telzo2000/cool844/qmk_firmware/keyboards/cool844/readme.md

# cool844

cool844

*A short description of the keyboard/project*

* Keyboard Maintainer: [m.ki](https://github.com/yourusername)
* Hardware Supported: *The PCBs, controllers supported*
* Hardware Availability: *Links to where you can find this hardware*

Make example for this keyboard (after setting up your build environment):

    make cool844:default

Flashing example for this keyboard:

    make cool844:default:flash

See the [build environment setup](https://docs.qmk.fm/#/getting_started_build_tools) and the [make instructions](https://docs.qmk.fm/#/getting_started_make_guide) for more information. Brand new to QMK? Start with our [Complete Newbs Guide](https://docs.qmk.fm/#/newbs).
