telzo2000/cool844/img/img01.png

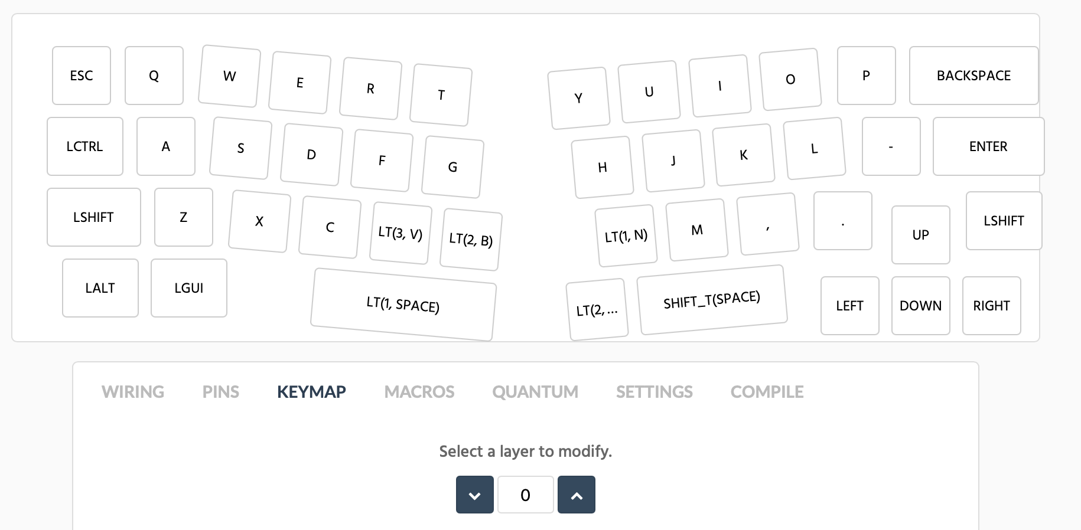
img/img01.png
