telzo2000/cool844/img/img02.png

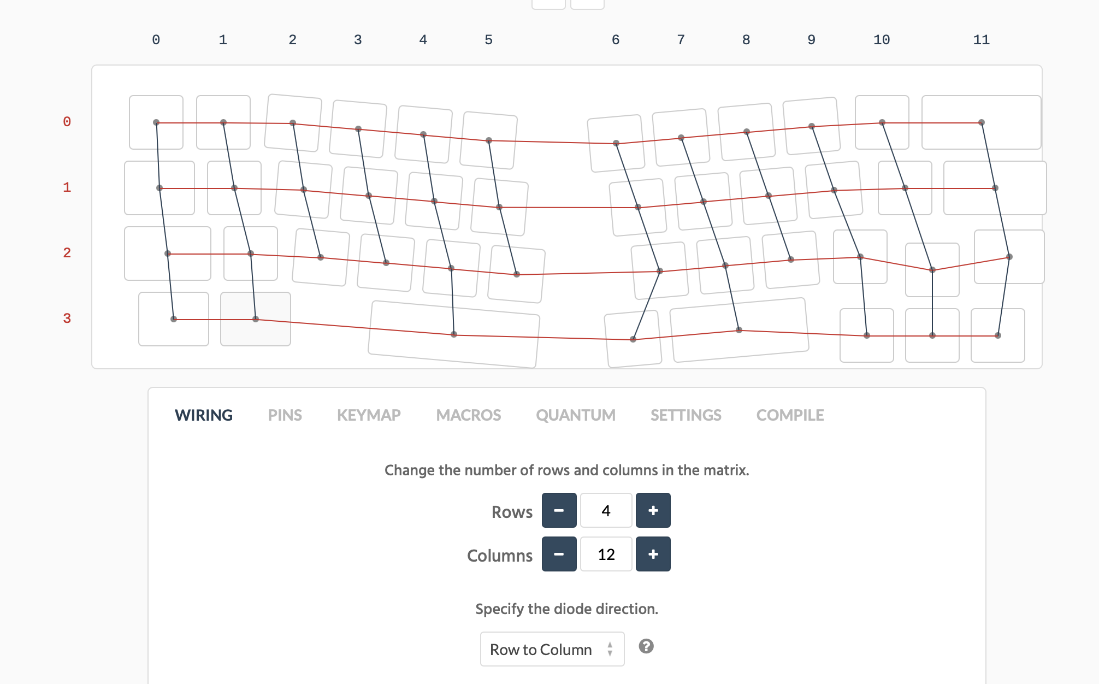
img/img02.png
