telzo2000/cool844/img/img03.png

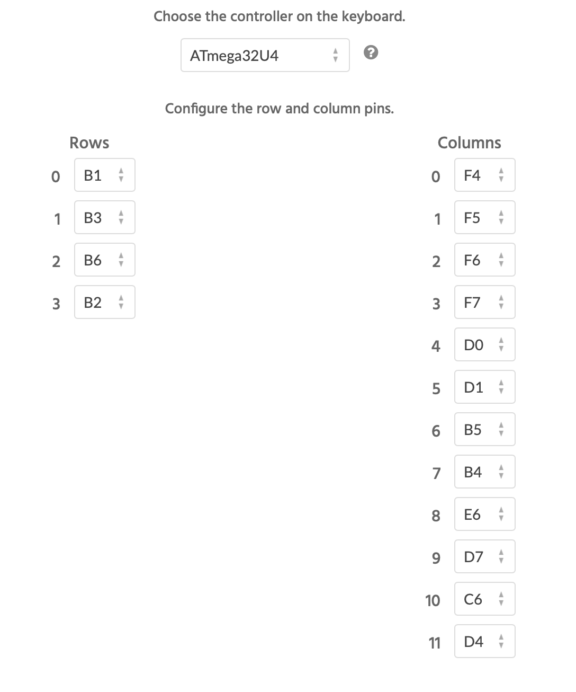
img/img03.png
