telzo2000/cool844/img/img04.png

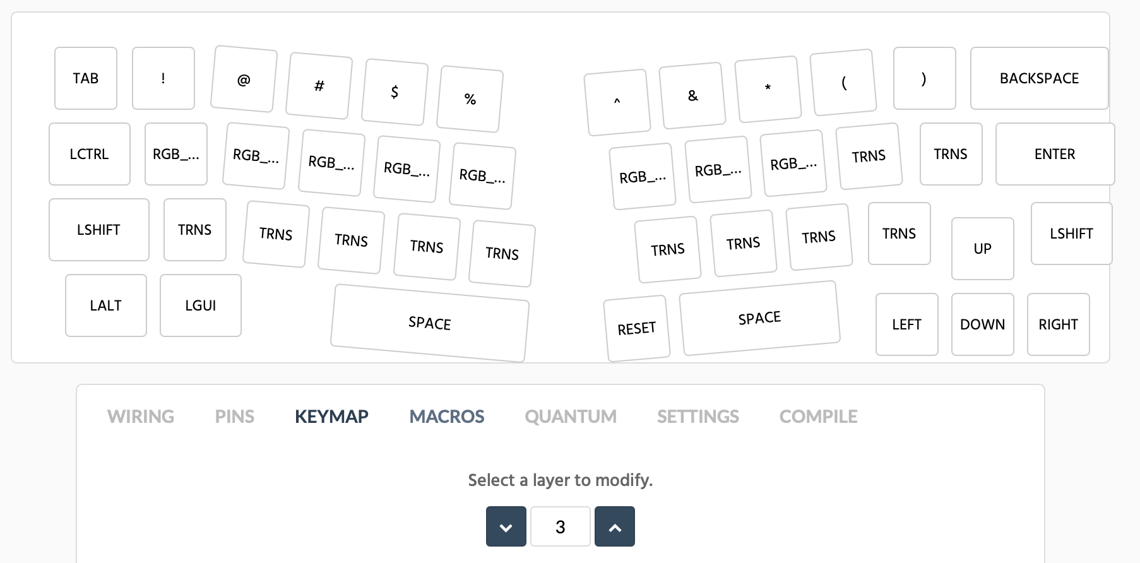
img/img04.png
