telzo2000/cool844/img/img05.png

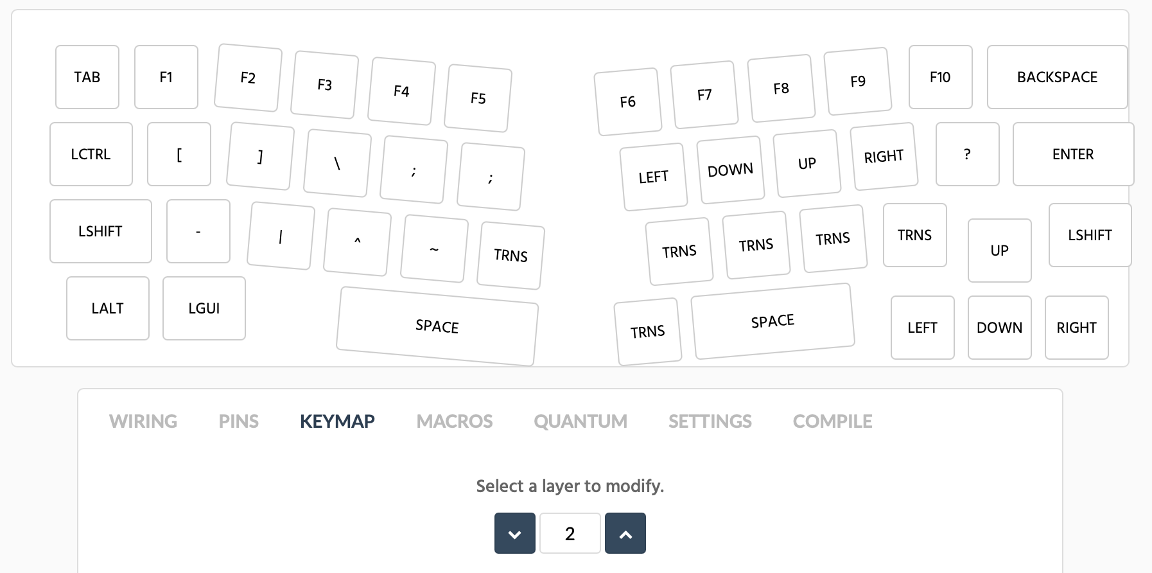
img/img05.png
