telzo2000/cool844/img/img06.png

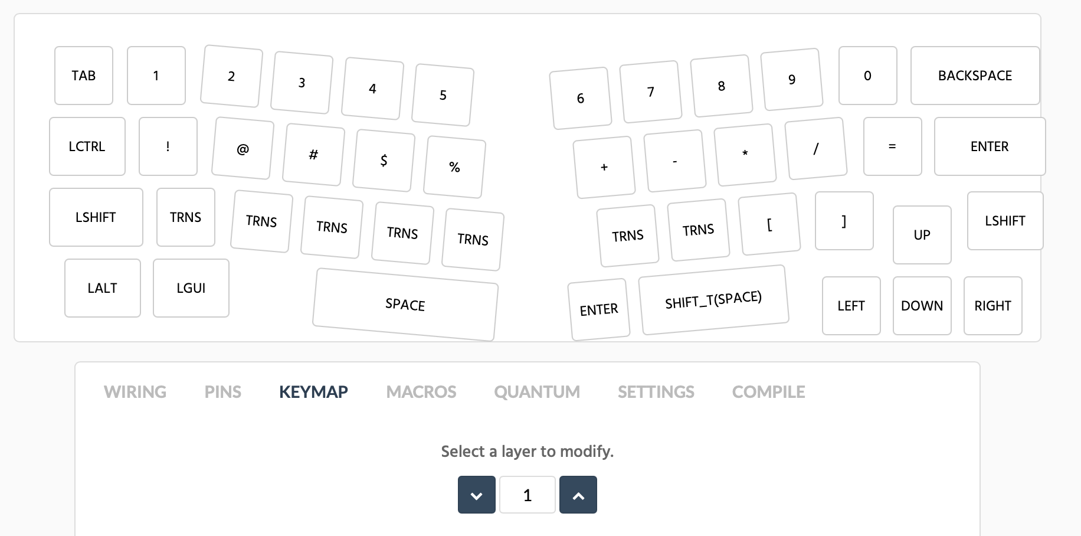
img/img06.png
