telzo2000/cool844/img/img07.png

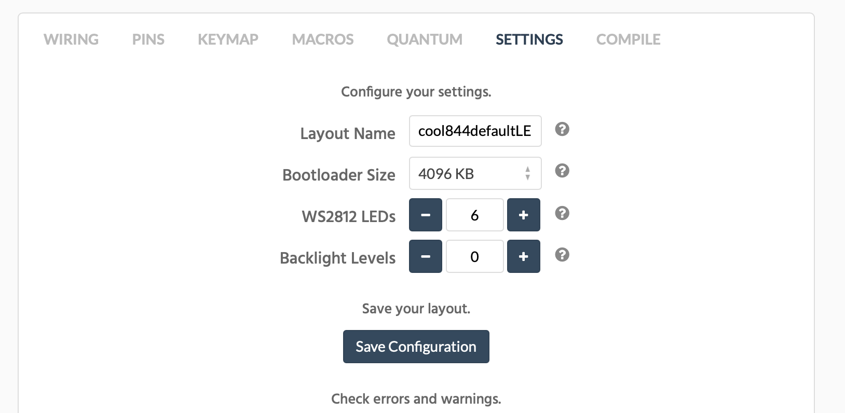
img/img07.png
