telzo2000/cool844/img/IMG_4266.jpg

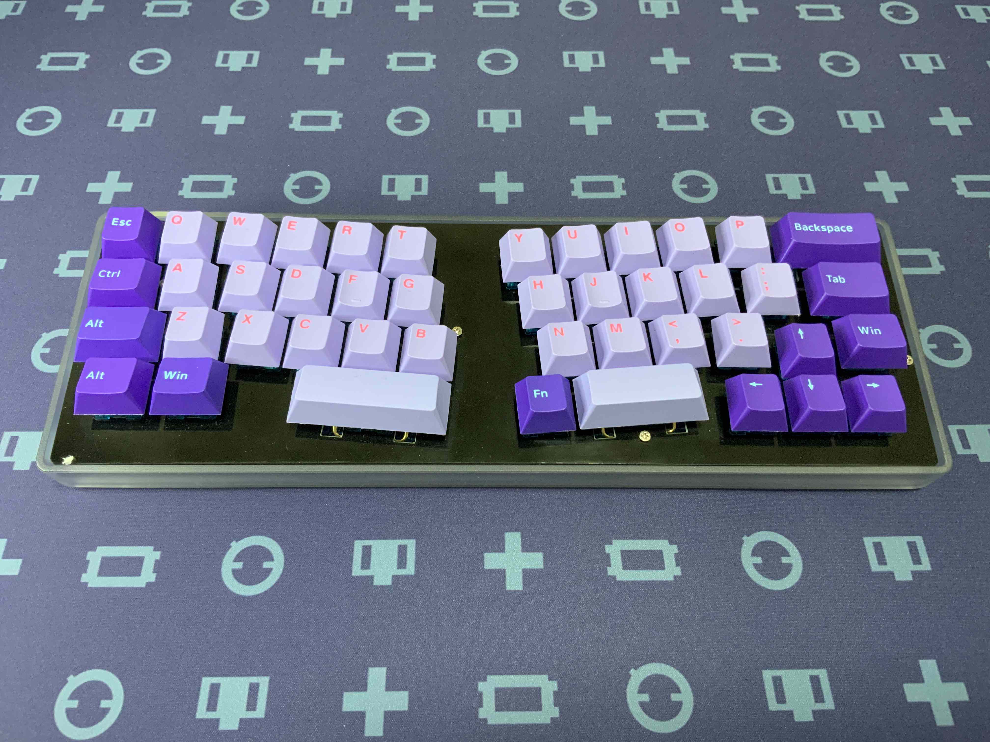
img/IMG_4266.jpg
