telzo2000/cool844/img/IMG_4267.jpg

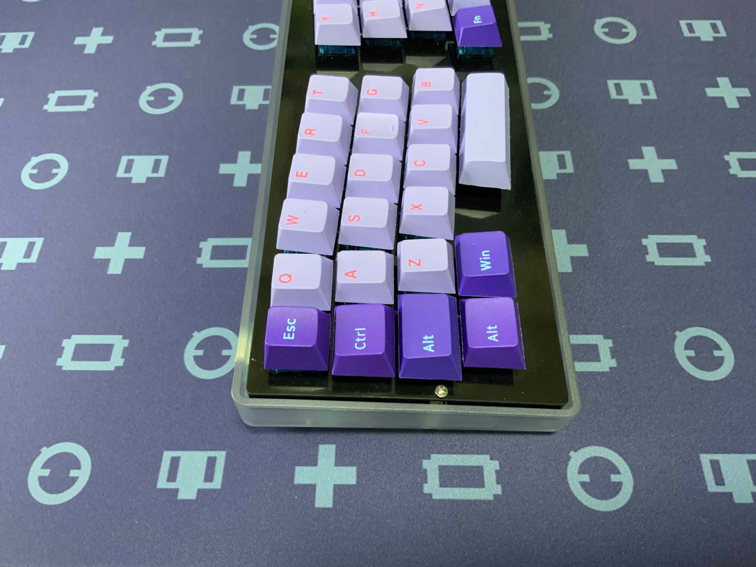
img/IMG_4267.jpg
