telzo2000/cool844/img/IMG_4268.jpg

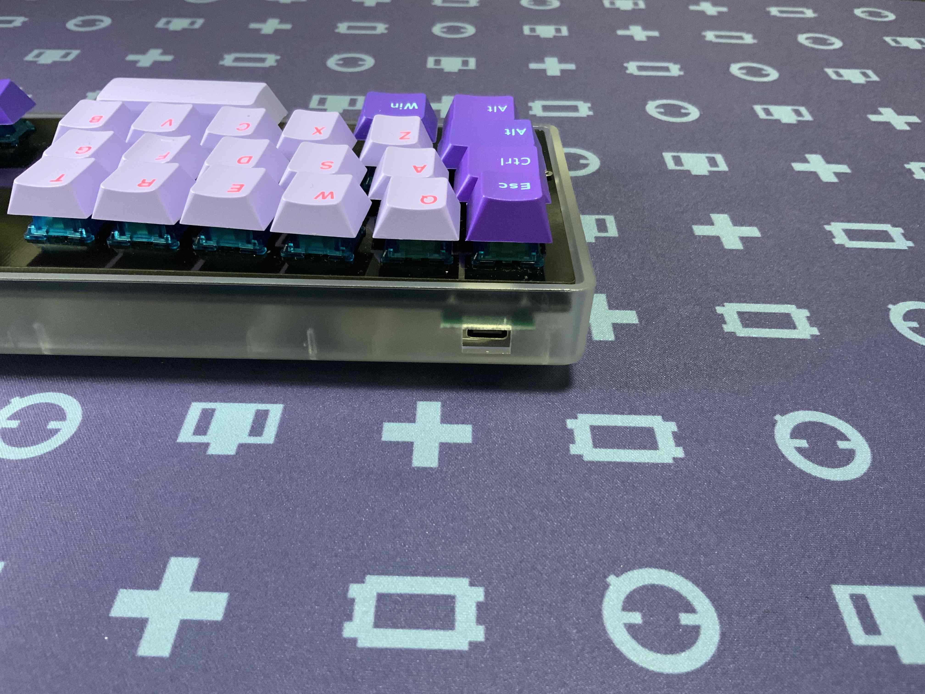
img/IMG_4268.jpg
