telzo2000/cool844/img/IMG_4269.jpg

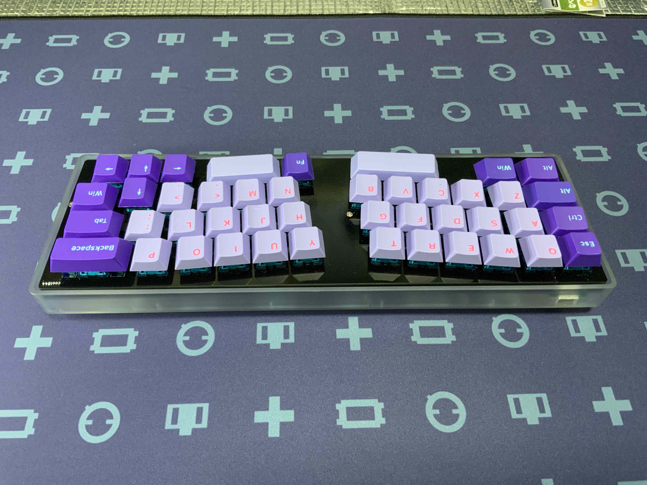
img/IMG_4269.jpg
