telzo2000/cool844/img/IMG_4270.jpg

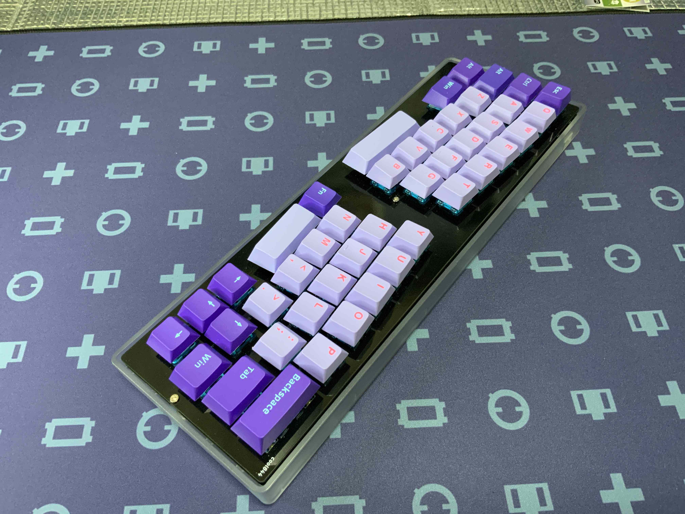
img/IMG_4270.jpg
