telzo2000/cool844/img/IMG_4271.jpg

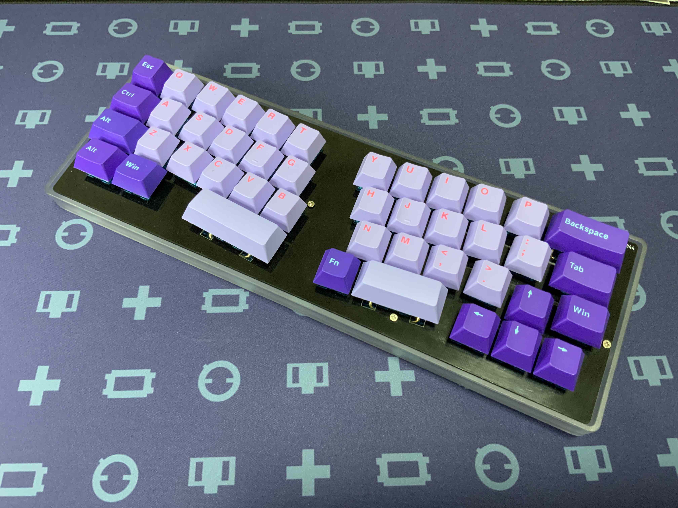
img/IMG_4271.jpg
