telzo2000/cool844/img/remap001.png

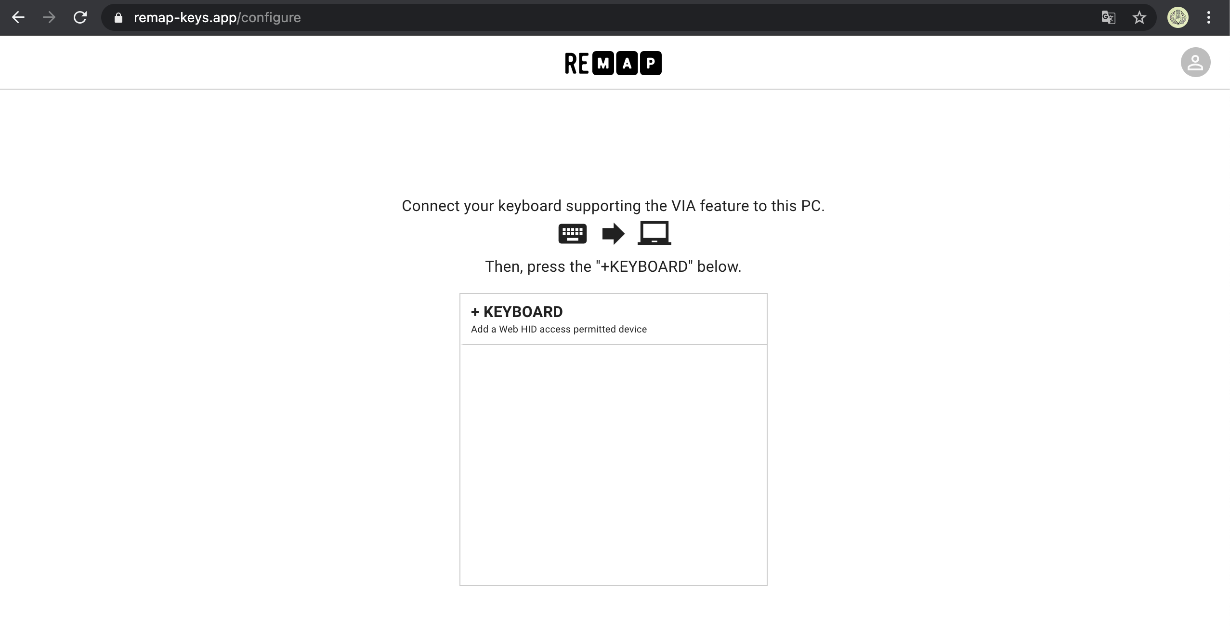
img/remap001.png
