telzo2000/cool844/img/remap002.png

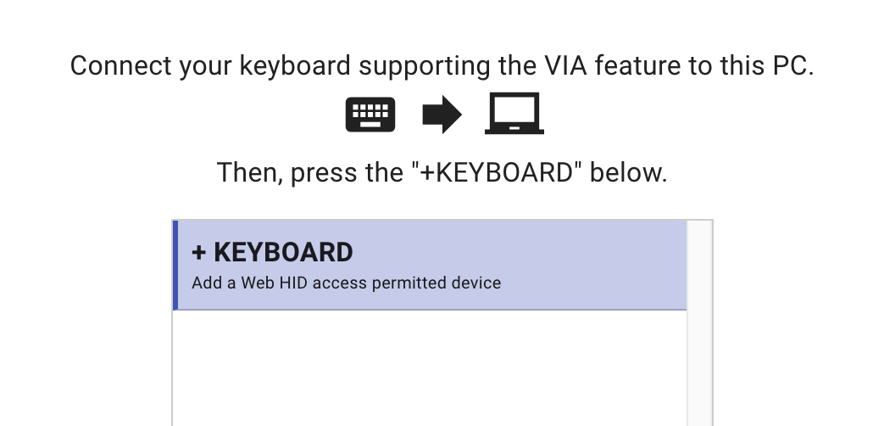
img/remap002.png
