telzo2000/cool844/img/remap003.png

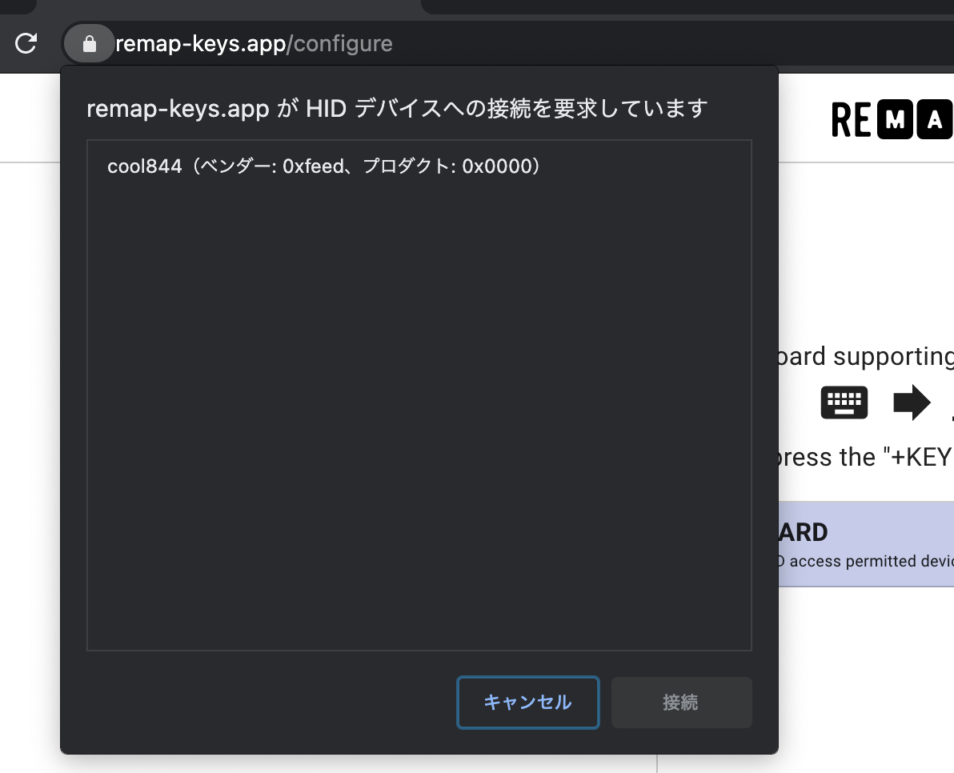
img/remap003.png
