telzo2000/cool844/img/remap004.png

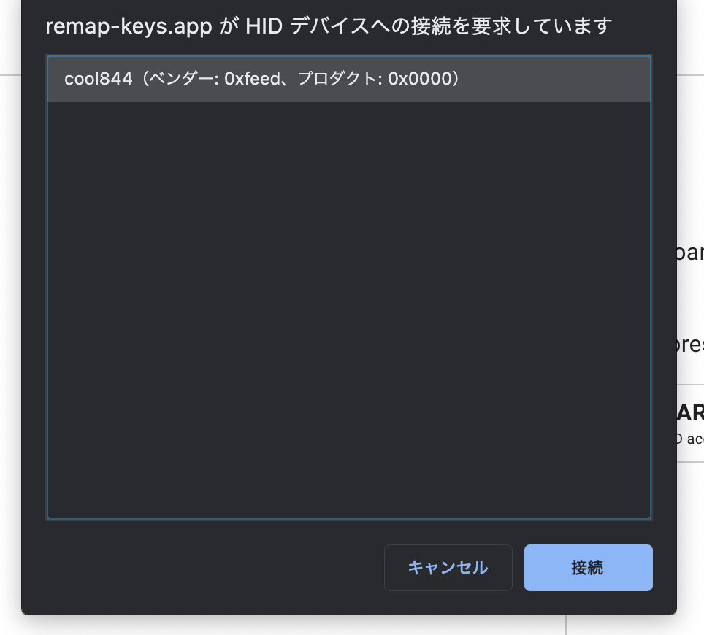
img/remap004.png
