telzo2000/cool844/img/remap005.png

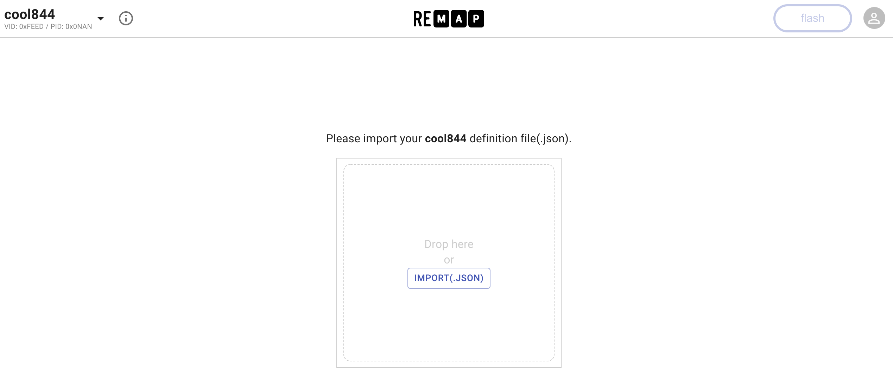
img/remap005.png
