telzo2000/cool844/img/remap006.png

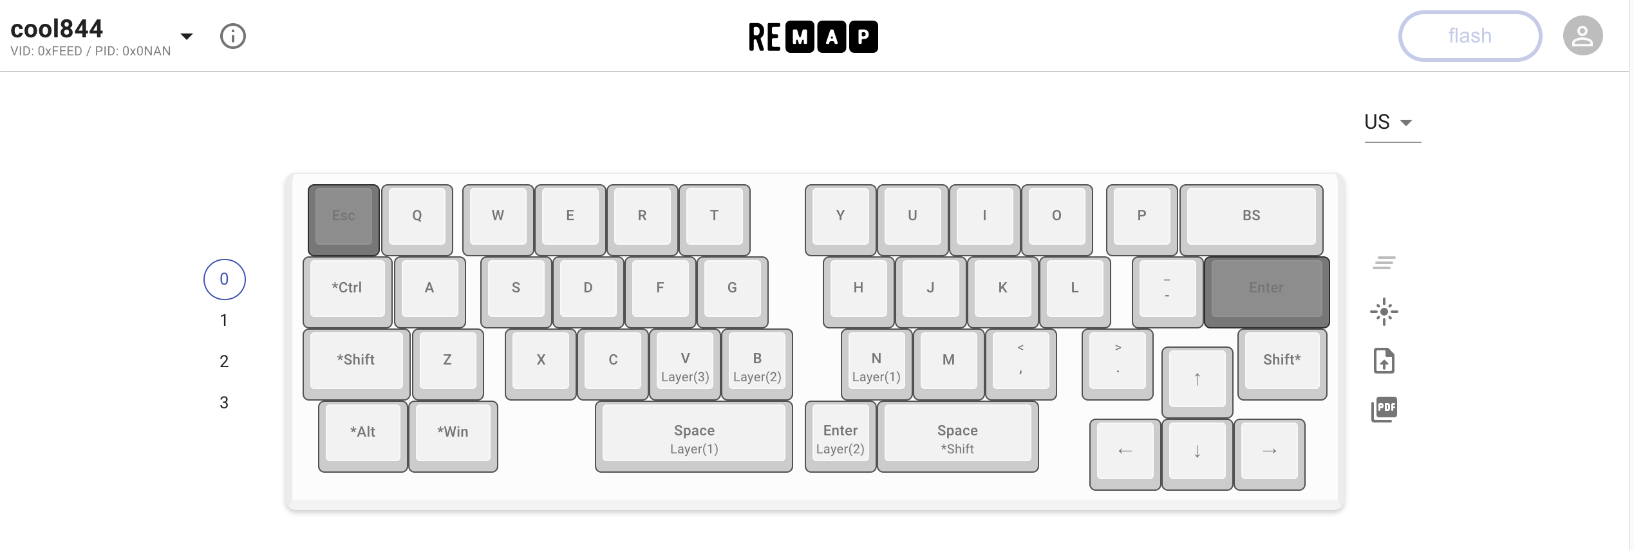
img/remap006.png
