telzo2000/cool844/buildguideforcool844.md

# cool844ビルドガイド

## ◯同封されているもの

スイッチプレート　１枚<br>
PCB １枚<br>

## ◯別途に購入するもの（１）
M2スペーサー10mm 5個<br>
M2ネジ15mm 5本<br>
ウレタンケーブル25cm<br>
ダイオード　44本<br>
MXソケット　44個<br>
タクトスイッチ　1個<br>
キースイッチ　44個<br>
キーキャップ<br>
スタビライザー２U ３個<br>
pro micro １個<br>
スプリングピンヘッダ（マックエイトコンスルー）２個<br>
フルカラーシリアルLEDテープ　２枚<br>
※これらのものについては、[遊舎工房](https://shop.yushakobo.jp)、[TALP KEYBOARDs](https://talpkeyboard.stores.jp)、[KOCHI KEYBOARD](https://kochikeyboard.stores.jp)等国内で自作キーボードに関する部品等を取り扱っているお店で購入することができます。M2スペーサー10mmは、外径の小さいものが最適です[KOCHI KEYBOARD](https://kochikeyboard.stores.jp)で[取り扱っているもの](https://kochikeyboard.stores.jp/items/5f8aabbdd24eee436e27e967)を推奨します。
<br>

## ◯別途に購入するもの（２）
[マイクロUSB端子（オス）](https://akizukidenshi.com/catalog/g/gC-07666/)<br>
[USB タイプC基板](https://akizukidenshi.com/catalog/g/gK-15426/)<br>
※これらのものについては、[秋月電子通商](https://akizukidenshi.com/catalog/)で購入することができます。

## ◯別途に購入するもの（3）
ケース
※GH60系60％キーボードケースを使うことを前提になっています。国内では[遊舎工房](https://shop.yushakobo.jp)等で、海外では[Ali Expresse](https://best.aliexpress.com/)等で同じようなケースを材質ごとに、見つけることができます。cool844がケース全てに使えるか確認することは、個人の裁量を超えます。購入者の自己責任でお願いします。
<br>

## ◯ファームウェア
このキーボードはQMKというキーボード用のソフトウェアで動作するようにプログラミングしています。<br>
[Yoichiro Tanaka@yoichiro](https://twitter.com/yoichiro)さん等が開発した[REMAP](https://remap-keys.app/)が使用できます。
<br>
pro microとPCをUSBケーブルで繋ぎ、google chromeで[REMAP](https://remap-keys.app/)サイトへアクセスしてください。<br>

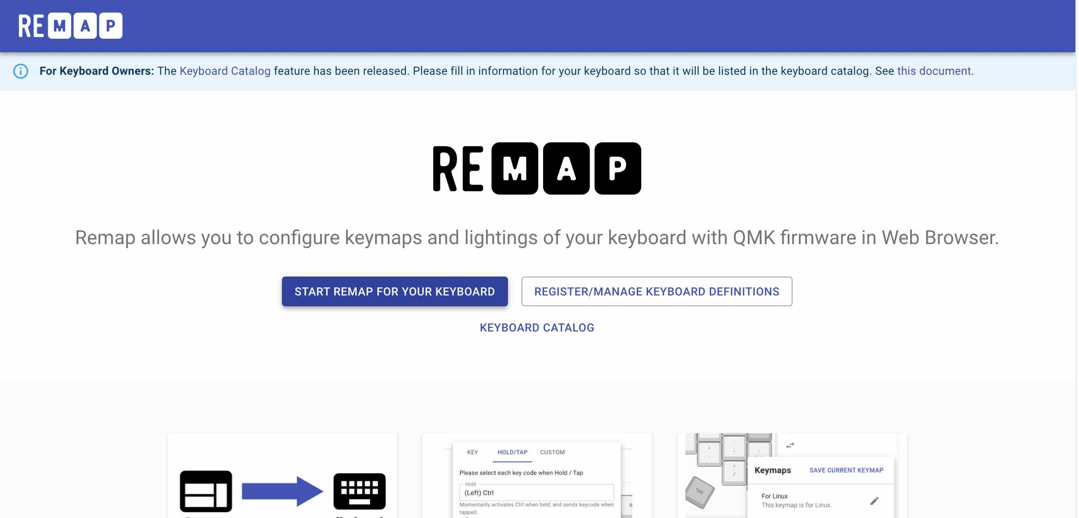
[picture p22: img/img00079.jpg]


画面中央の「KEYBOARD CATALOG」をクリックしてください。<br>
画面が変わりましたら、左上の「Keyboard Name」に「cool」と
入力して、下部の「SEARCH」をクリックしてください。
<br>
coolシリーズのキーボードが表示されます。
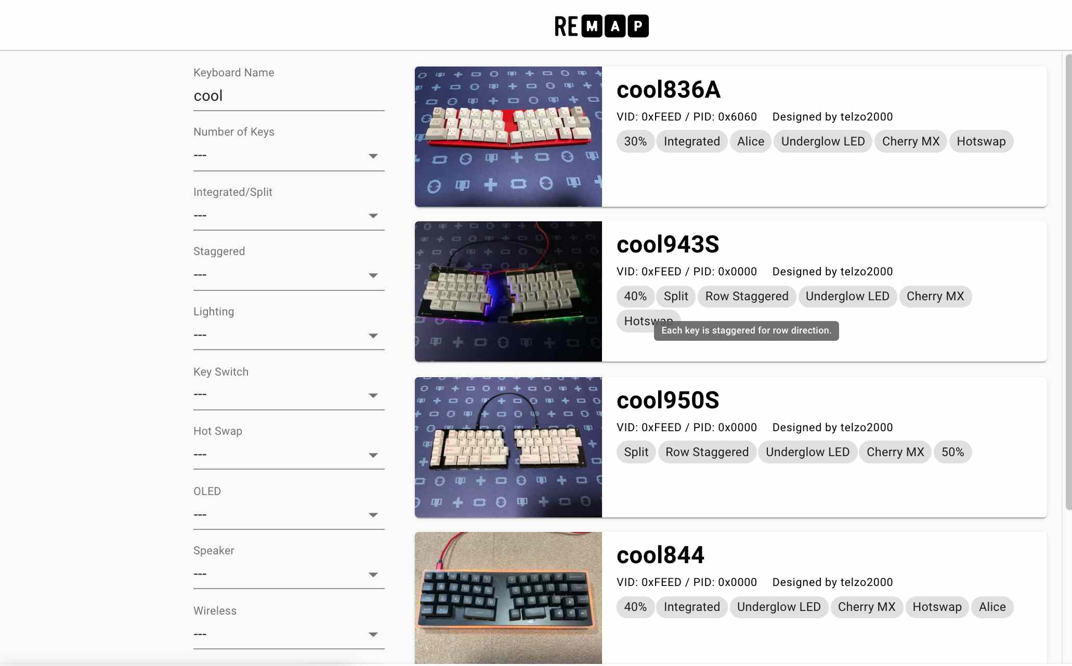
[picture p23: img/img00080.jpg]

この中から、該当するキーボードを選び、クリックしてください。
<br>
例えば、cool844であれば、次の画面に変わります。
そこでタブの「FIRMWARE」をクリックすると、
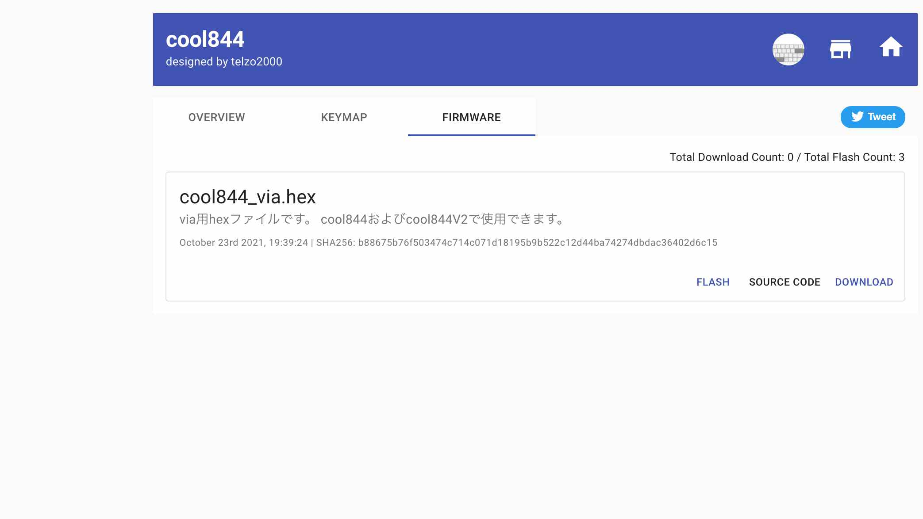
[picture p24: img/img00081.jpg]

このように、via用hexファイルが表示されます。
「FLASH」をクリックすると、
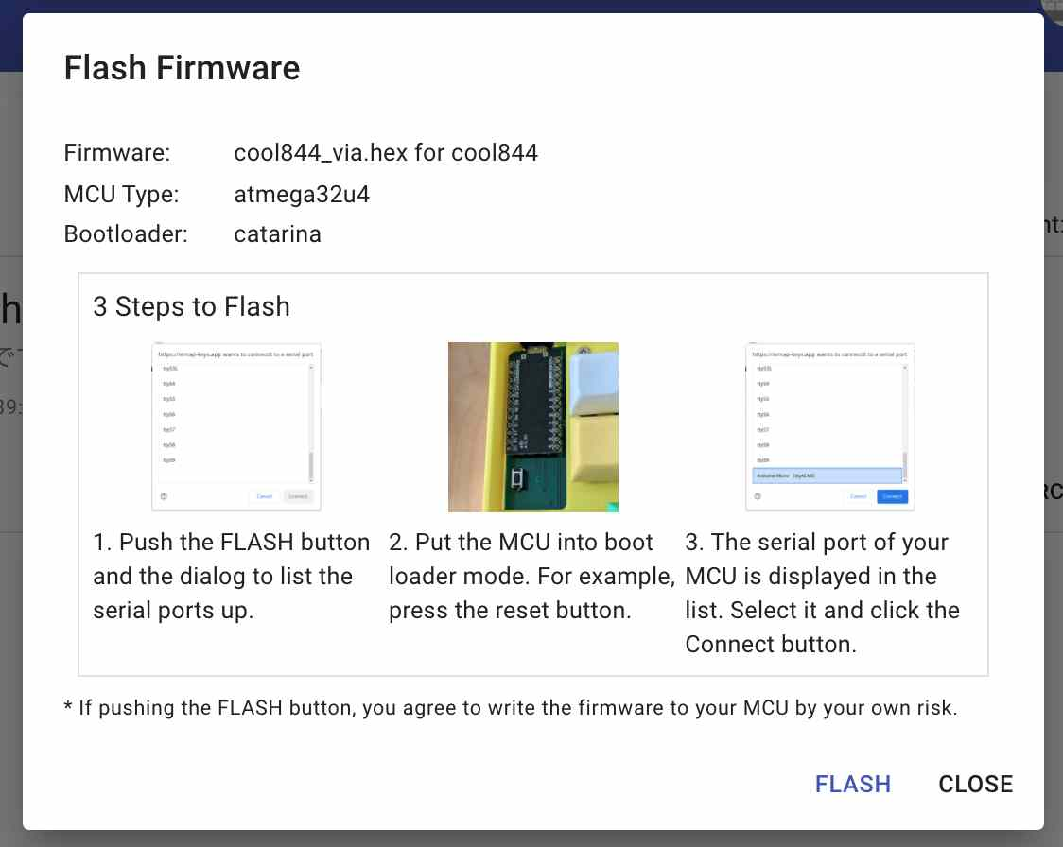
[picture p25: img/img00082.jpg]

Flash Firmwareが起動して、pro microへの書き込みができます。
<br>
以上で、pro microへのファームウェアの書き込みは完了です。
<br>
REMAPのおかげで、自作キーボードのファームウェアの書き込み、キーレイアウトの変更が大変、簡単になりました。
<br>
<br>
## ◯組み立て

### １　表裏面の確認
スイッチプレートとPCBは、表面の右上にcool 844と印字されています。特にPCBは、diode 、socketと印字されている面が裏面です。

### ２　ダイオードのハンダ付け
PCB 裏面にダイオードのハンダ付けをします。ダイオードの足を曲げて取り付けて、ハンダ付けをします。ダイオードの足は、下面から「diode」と印刷された部分の穴に差し込みます。上面に伸びたダイオードの足は切り離してください。ダイオードには極性があります。ダイオードの黒い帯がある側が「diode」の文字の後ろになるようにハンダ付けしてください。ハンダ付けに自信がない場合、フラックスを利用すると、上手にハンダ付けができます。その後、フラックスクリーナーで綺麗に拭き取ることをお勧めします。１箇所印字されていないミスが確認できています。それ以外のダイオードのハンダ付けを参考にして、ハンダ付けをしてください。

### ３　MXソケットのハンダ付け
PCB 裏面にMXソケットのハンダ付けをします。PCB 裏面の端子箇所に多めにフラックスを塗布して、予備ハンダをしてください。MXソケットをsocket と印字を隠すように置いて、ハンダゴテを当てて、予備ハンダを溶かしながら、ハンダ付けをしてください。

### ４　タクトスイッチの取り付け
PCB裏面にresetと書かれた箇所があります。そこにタクトスイッチをハンダ付けしてください。

### ５　pro microの取り付け<br>
　本製品ではコンスルー（スプリングピンヘッダ）を使用してのpro microの装着を推奨しています。コンスルー（スプリングピンヘッダ）の向きに気をつけて使用してください。画像を参考にして、pro microの向きに注意してください。<br>
pro microを装着したさ、pro microの基板がたくさん載っている側が下向きになります。cool836AのVer.C+（イエローバージョン）と同じ付け方になります。

### ６ ドーターボードの作成と取り付け
ドーターボードの作成は[こちら](https://github.com/telzo2000/Hello_keyboard/blob/main/dbforcool844/buildlog.md)になります。
取り付け方は、次の画像（試作品）を参考にしてください。<br>
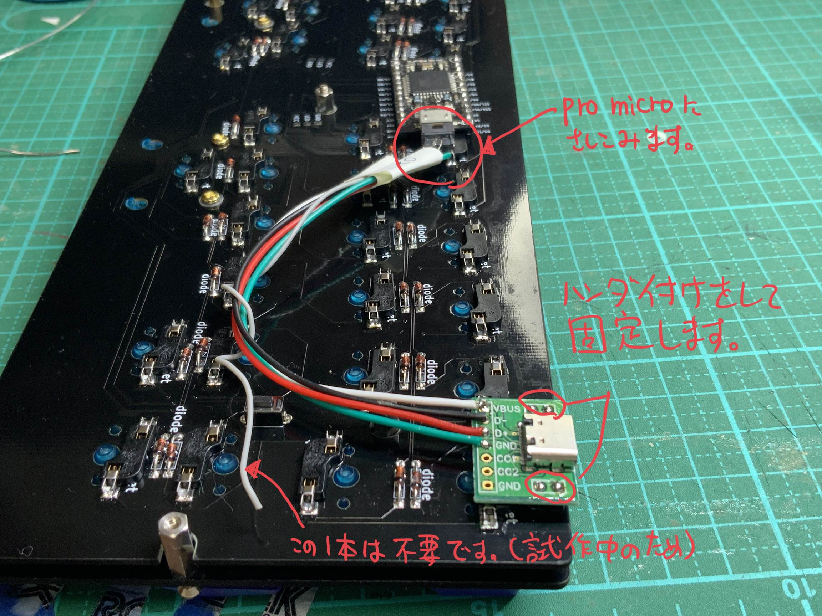
[picture p26: img/IMG_4257.jpg]

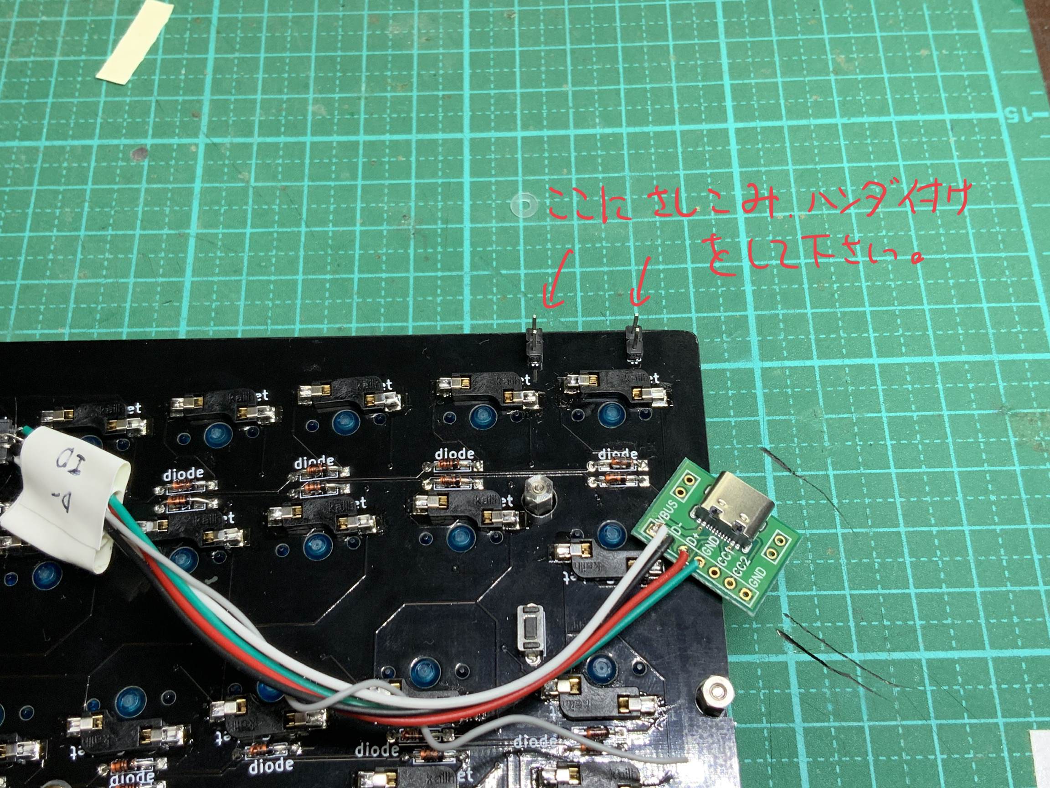
[picture p27: img/IMG_4255.jpg]

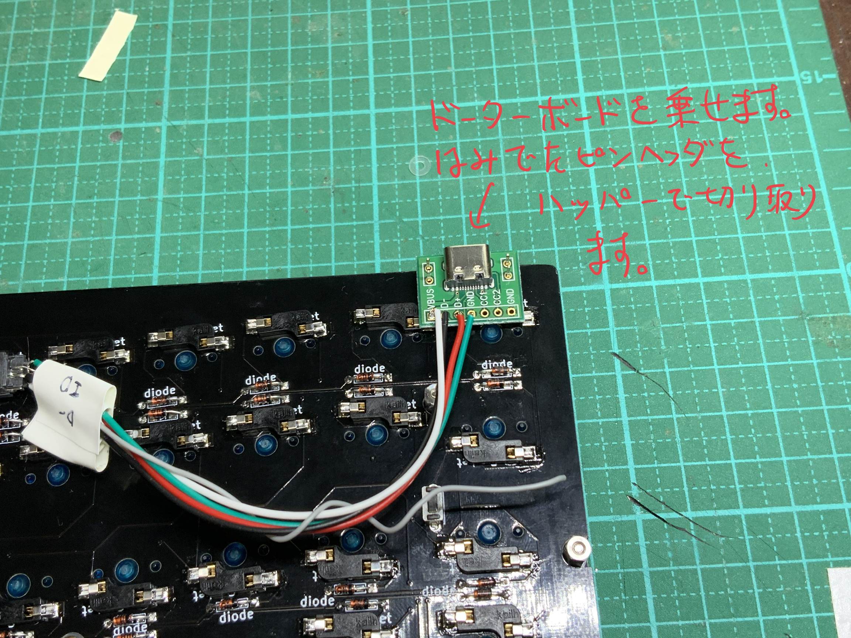
[picture p28: img/IMG_4256.jpg]


（令和3年10月27日追記）取り付けの際、PCBとUSBタイプC基板との間隔を３〜４mmにしてください。
この間隔は、ケースのUSB挿し込み口と位置を合わせてからハンダ付けをしてください。
### ７　スタビライザーの取り付け
PCB表面３箇所に、２Uのスタビライザーを取り付けます。スタビライザーに事前に、ルブしておくことをお勧めします。

### ８　キースイッチの取り付け<br>
最初にキースイッチ５個をトッププレートの５箇所（四隅と一番手前）に差し込みます。一度に全部のキースイッチを取り付けて、その後にPCBにハンダ付けしたMXソケットに差し込むとうまくいかないことが予想されます。５箇所で一度PCBにハンダ付けしたMXソケットに差し込み、残りのキースイッチをトッププレート、PCBの順に差し込んでください。それぞれのキースイッチの足がきちんとMXソケットの基板の穴に差し込まれていることを確認してください。差し込むときに、足が曲がってしまうことがあります。その場合は、ボタンを押しても入力されません。一度キースイッチを外して、足の修正または新しいキースイッチに交換等対処してください。

### 9 フルカラーシリアルLEDテープの取り付け
PCB裏面に、テープの裏面の保護紙を剥がして貼り付けます。その後、それぞれの端子にハンダを山盛りにして導通させてください。
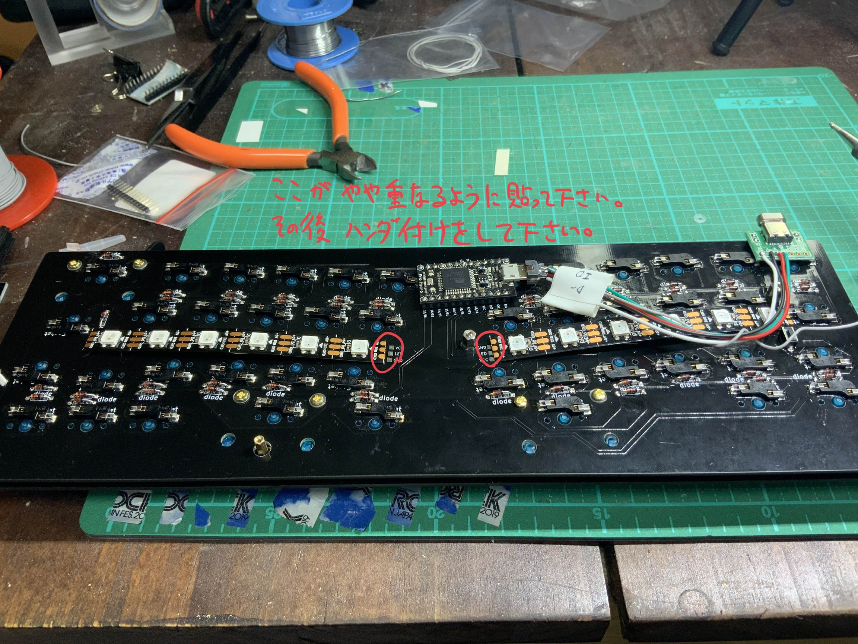
[picture p29: img/IMG_4258.jpg]

この後、ファームウェアを入れて、入力できるかテストをしてください。

### 10　ネジ、スペーサーの取り付け
スイッチプレート表面からネジを通して、スペーサーも通しておきます。５箇所全て、その状態にします。<br>
ケースにスイッチプレート等を差し込んで、ネジを締めます。締めたり、緩めたりを繰り返すうちに、ネジ山が上手に溝に入り込んで、締めることができます。プラスチック製ケースではスイッチプレートがケース壁面上部より１mm程度下がった位置で、ネジは締まりました。締めすぎて、ネジ山を壊さないよう、注意してください。
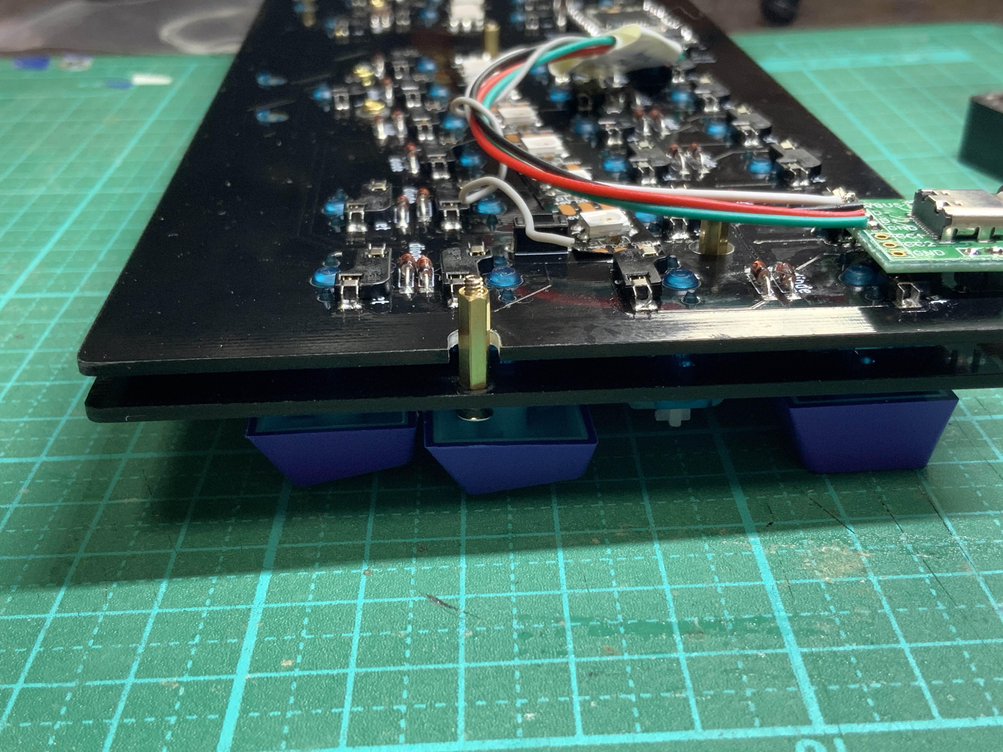
[picture p30: img/IMG_4259.jpg]


### 11　右奥箇所のねじ止め（ver.1.1）
ケース右奥箇所の固定のため、PCBの一部に作成されたプレート（リーフ）を切り離してください。<br>
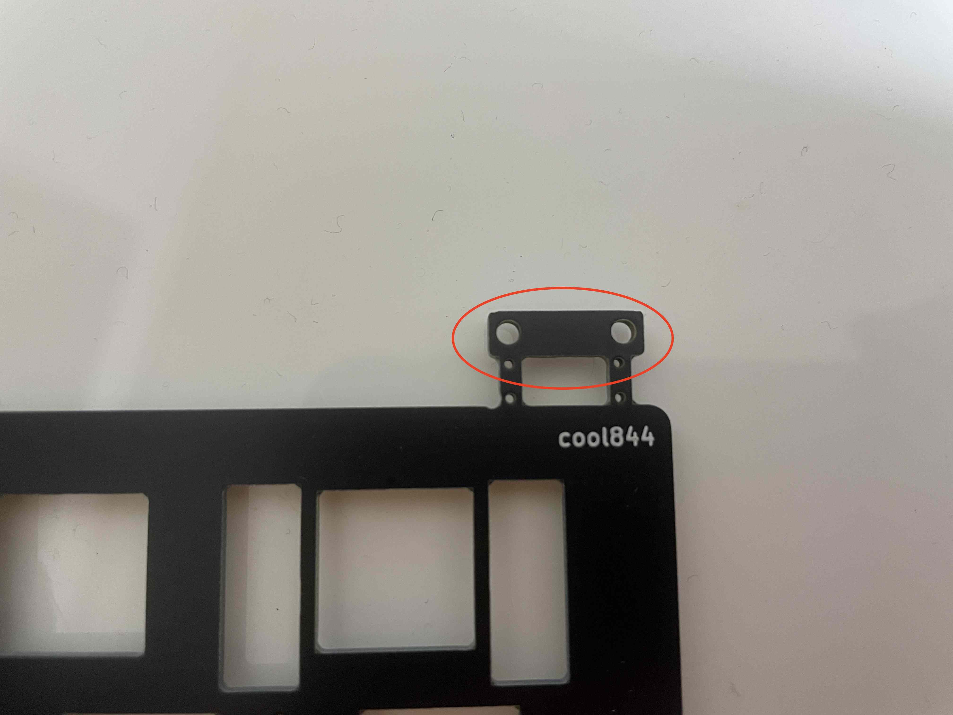
[picture p31: img/IMG_0935.jpg]

このパーツをM2ネジ４mm２本、ワッシャー１枚、M2スペーサー８mmを組み合わせて、次のようにしてください。<br>
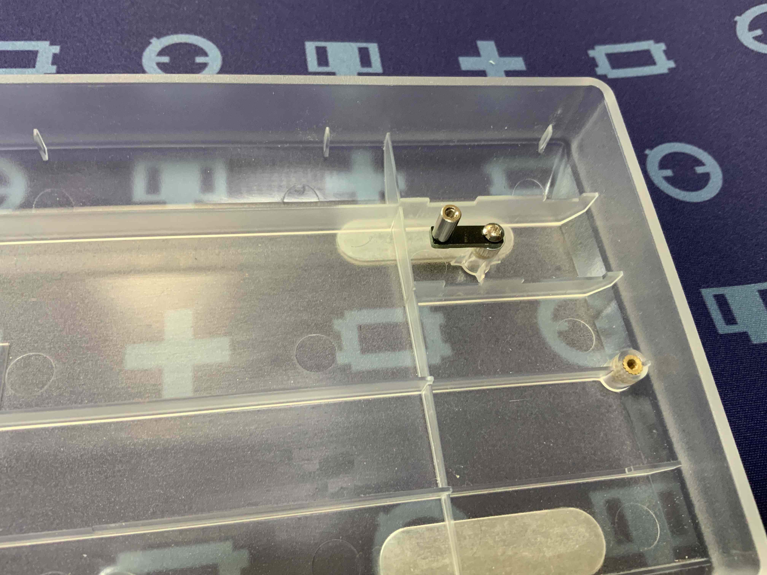
[picture p32: img/IMG_4441.jpg]

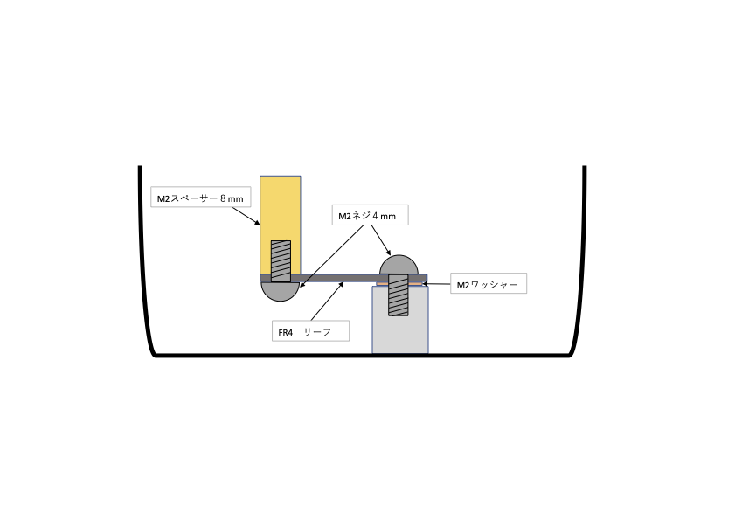
[picture p33: img/img08.png]


全体像としては、次の通りです。
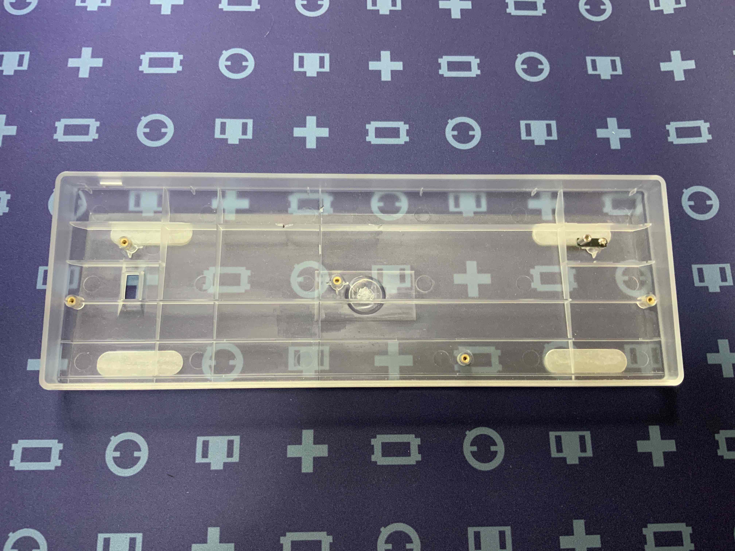
[picture p34: img/IMG_4440.jpg]

この箇所（次の画像の赤丸部分）をスイッチプレートで固定するときは、M2ネジ４mmを使用してください。<br>
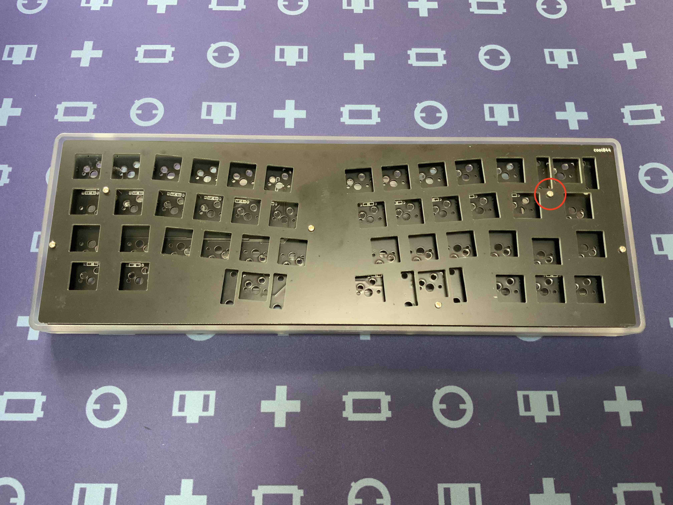
[picture p35: img/IMG_4439.jpg]


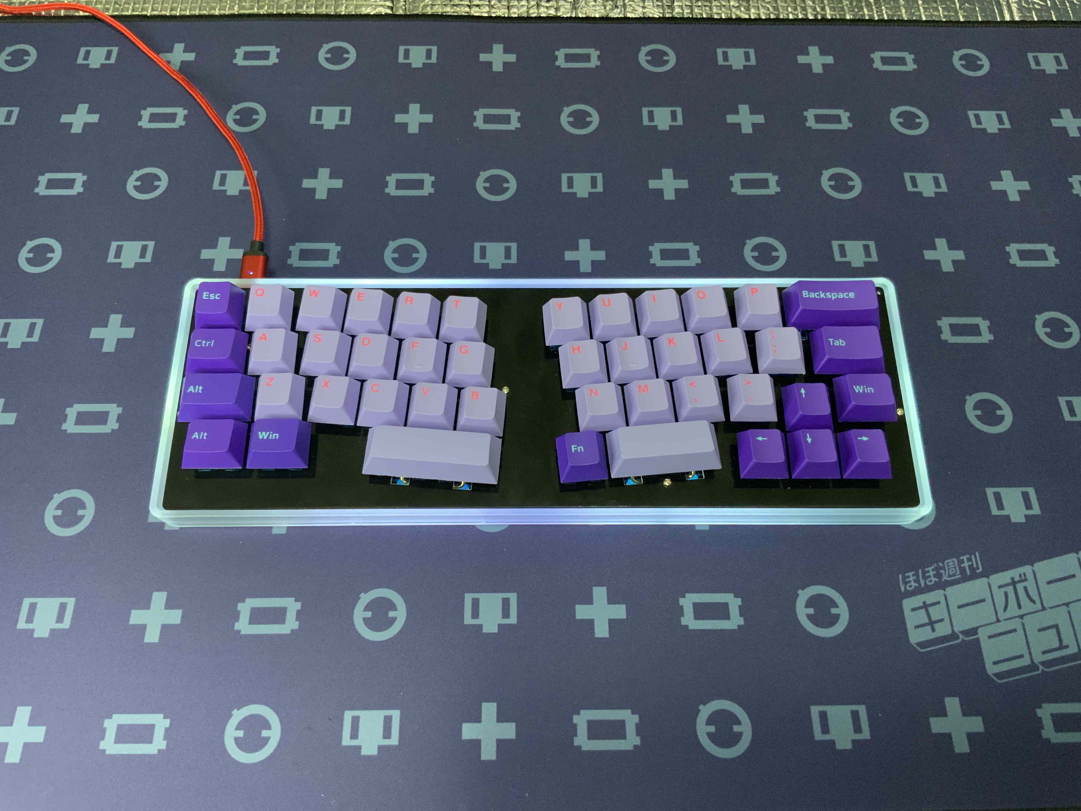
[picture p36: img/IMG_4299.jpg]
