telzo2000/cool844/qmk_firmware/keyboards/cool844/config.h

/*
Copyright 2021 m.ki

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
You should have received a copy of the GNU General Public License
along with this program.  If not, see <http://www.gnu.org/licenses/>.
*/

#pragma once

#include "config_common.h"

/* USB Device descriptor parameter */
#define VENDOR_ID    0xFEED
#define PRODUCT_ID   0x0000
#define DEVICE_VER   0x0001
#define MANUFACTURER m.ki
#define PRODUCT      cool844

/* key matrix size */
#define MATRIX_ROWS 4
#define MATRIX_COLS 12

/*
 * Keyboard Matrix Assignments
 *
 * Change this to how you wired your keyboard
 * COLS: AVR pins used for columns, left to right
 * ROWS: AVR pins used for rows, top to bottom
 * DIODE_DIRECTION: COL2ROW = COL = Anode (+), ROW = Cathode (-, marked on diode)
 *                  ROW2COL = ROW = Anode (+), COL = Cathode (-, marked on diode)
 *
 */
#define MATRIX_ROW_PINS { B1,B3,B6,B2 }
#define MATRIX_COL_PINS { F4,F5,F6,F7,D0,D1,B5,B4,E6,D7,C6,D4 }
#define UNUSED_PINS

/* COL2ROW, ROW2COL */
#define DIODE_DIRECTION ROW2COL

/*
 * Split Keyboard specific options, make sure you have 'SPLIT_KEYBOARD = yes' in your rules.mk, and define SOFT_SERIAL_PIN.
 */
#define SOFT_SERIAL_PIN D0  // or D1, D2, D3, E6

#define RGB_DI_PIN D3
#ifdef RGB_DI_PIN
#    define RGBLED_NUM 16
#    define RGBLIGHT_HUE_STEP 16
#    define RGBLIGHT_SAT_STEP 16
#    define RGBLIGHT_VAL_STEP 16
#    define RGBLIGHT_LIMIT_VAL 255 /* The maximum brightness level */
#    define RGBLIGHT_SLEEP  /* If defined, the RGB lighting will be switched off when the host goes to sleep */
/*== all animations enable ==*/
#    define RGBLIGHT_ANIMATIONS
/*== or choose animations ==*/
#    define RGBLIGHT_EFFECT_BREATHING
#    define RGBLIGHT_EFFECT_RAINBOW_MOOD
#    define RGBLIGHT_EFFECT_RAINBOW_SWIRL
#    define RGBLIGHT_EFFECT_SNAKE
#    define RGBLIGHT_EFFECT_KNIGHT
#    define RGBLIGHT_EFFECT_CHRISTMAS
#    define RGBLIGHT_EFFECT_STATIC_GRADIENT
#    define RGBLIGHT_EFFECT_RGB_TEST
#    define RGBLIGHT_EFFECT_ALTERNATING
/*== customize breathing effect ==*/
/*==== (DEFAULT) use fixed table instead of exp() and sin() ====*/
#    define RGBLIGHT_BREATHE_TABLE_SIZE 256      // 256(default) or 128 or 64
/*==== use exp() and sin() ====*/
#    define RGBLIGHT_EFFECT_BREATHE_CENTER 1.85  // 1 to 2.7
#    define RGBLIGHT_EFFECT_BREATHE_MAX    255   // 0 to 255
#endif

/* Debounce reduces chatter (unintended double-presses) - set 0 if debouncing is not needed */
#define DEBOUNCE 5

/* define if matrix has ghost (lacks anti-ghosting diodes) */
//#define MATRIX_HAS_GHOST

/* Mechanical locking support. Use KC_LCAP, KC_LNUM or KC_LSCR instead in keymap */
#define LOCKING_SUPPORT_ENABLE
/* Locking resynchronize hack */
#define LOCKING_RESYNC_ENABLE

/* If defined, GRAVE_ESC will always act as ESC when CTRL is held.
 * This is useful for the Windows task manager shortcut (ctrl+shift+esc).
 */
//#define GRAVE_ESC_CTRL_OVERRIDE

/*
 * Force NKRO
 *
 * Force NKRO (nKey Rollover) to be enabled by default, regardless of the saved
 * state in the bootmagic EEPROM settings. (Note that NKRO must be enabled in the
 * makefile for this to work.)
 *
 * If forced on, NKRO can be disabled via magic key (default = LShift+RShift+N)
 * until the next keyboard reset.
 *
 * NKRO may prevent your keystrokes from being detected in the BIOS, but it is
 * fully operational during normal computer usage.
 *
 * For a less heavy-handed approach, enable NKRO via magic key (LShift+RShift+N)
 * or via bootmagic (hold SPACE+N while plugging in the keyboard). Once set by
 * bootmagic, NKRO mode will always be enabled until it is toggled again during a
 * power-up.
 *
 */
//#define FORCE_NKRO

/*
 * Feature disable options
 *  These options are also useful to firmware size reduction.
 */

/* disable debug print */
//#define NO_DEBUG

/* disable print */
//#define NO_PRINT

/* disable action features */
//#define NO_ACTION_LAYER
//#define NO_ACTION_TAPPING
//#define NO_ACTION_ONESHOT

/* disable these deprecated features by default */
#define NO_ACTION_MACRO
#define NO_ACTION_FUNCTION

/* Bootmagic Lite key configuration */
//#define BOOTMAGIC_LITE_ROW 0
//#define BOOTMAGIC_LITE_COLUMN 0
