telzo2000/cool844/via@otahinosame/cool844/config.h

#ifndef CONFIG_H
#define CONFIG_H

#include "config_common.h"

/* USB Device descriptor parameter */
// TODO : fix VID and PID
#define VENDOR_ID       0xFEED
#define PRODUCT_ID      0x6060
#define DEVICE_VER      0x0001
#define MANUFACTURER    m.ki
#define PRODUCT         cool844
#define DESCRIPTION     Keyboard

/* key matrix size */
#define MATRIX_ROWS 4
#define MATRIX_COLS 12
// dynamic map layers number will limited to 9

/* key matrix pins */
#define MATRIX_ROW_PINS { B1, B3, B6, B2 }
#define MATRIX_COL_PINS { F4, F5, F6, F7, D0, D1, B5, B4, E6, D7, C6, D4 }
#define UNUSED_PINS

/* COL2ROW or ROW2COL */
#define DIODE_DIRECTION ROW2COL

/* number of backlight levels */

#ifdef BACKLIGHT_PIN
#define BACKLIGHT_LEVELS 0
#endif

/* Set 0 if debouncing isn't needed */
#define DEBOUNCING_DELAY 5

/* Mechanical locking support. Use KC_LCAP, KC_LNUM or KC_LSCR instead in keymap */
#define LOCKING_SUPPORT_ENABLE

/* Locking resynchronize hack */
#define LOCKING_RESYNC_ENABLE

/* key combination for command */
#define IS_COMMAND() ( \
    keyboard_report->mods == (MOD_BIT(KC_LSHIFT) | MOD_BIT(KC_RSHIFT)) \
)

/* prevent stuck modifiers */
#define PREVENT_STUCK_MODIFIERS

#define RGB_DI_PIN D3
#ifdef RGB_DI_PIN
#define RGBLIGHT_ANIMATIONS
#define RGBLED_NUM 6
#define RGBLIGHT_HUE_STEP 8
#define RGBLIGHT_SAT_STEP 8
#define RGBLIGHT_VAL_STEP 8
#endif

#endif
